CristianHuff/ConverterLoadCellToV12Lite/(commit log)

2026-06-20 Inicio do projeto de conversão dos pedais loadcell para base do PXN V12Lite
2026-06-20 Ajustes feitos para logs e calibração, projeto montado em protoboard validando o código
2026-06-21 Prototipado, validado no Gran Turismo 7 no Playstation 5, feito ajustes de calibração e testes.
2026-06-21 Adicionado led de indicação
2026-06-22 Internationalize project documentation and firmware
    - Translate README, BOM, docs, firmware comments, logs, and identifiers to English
    - Rename project files, docs, sketch folder, and schematics to English names
    - Update SVG schematic labels and layout for English text
    - Keep only the electronic schematic PNG and remove obsolete generated PNGs
    - Add calibration status LED and LED resistor to the root component list
2026-06-23 Add pedal profiles and update wiring docs
    - Add Linear/PC and GT7 inverse throttle pedal profiles
    - Apply GT7 throttle correction with an interpolated response table
    - Rework button handling for profile switching and calibration commands
    - Add LED feedback for active profile, clear, save, and hold states
    - Persist active profile only when calibration is saved to avoid EEPROM wear
    - Migrate old EEPROM calibration data on next calibration save
    - Update firmware, calibration, component, and diagnostics documentation
    - Update electronic schematic docs and SVG with the revised HX711 pin wiring
    [translator_box.ino]
2026-06-24 Add pedal profiles and stabilize bass shaker grounding
    - Add button flow for profile switching, calibration clear, and calibration save
    - Add LED feedback for profiles, hold thresholds, clear, and save actions
    - Persist the active profile only when calibration is saved to reduce EEPROM wear
    - Remap HX711 inputs and PWM outputs to match the board order: clutch, brake, throttle
    - Increase throttle dead zone to reject bass shaker vibration noise
    - Document RJ45 GND pins 2, 3, and 5 tied to common ground
    - Document bass shaker requirements: shared USB hub/reference and pedal frame bonded to translator box GND
    - Update firmware, calibration,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
    [translator_box.ino]
2026-06-28 Add PC gamepad serial bridge for Sim Ruito pedals
    Add a separate Arduino serial bridge firmware and browser-based PC bridge for using the original Sim Ruito board as the pedal reader.
    Summary:
    - Add serial_pedal_bridge Arduino sketch that receives brake/throttle/clutch percentages over USB serial and outputs PXN-compatible PWM signals.
    - Add browser Gamepad/Web Serial bridge for reading Sim Ruito pedals from the PC and sending mapped pedal values to Arduino.
    - Add Sim Ruito default axis mapping: brake axis 2, throttle axis 3, clutch axis 1.
    - Persist gamepad selection, axis mapping, calibration ranges, filters, and serial permissions where supported by the browser.
    - Add serial heartbeat, s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
2026-06-28 Build modular browser bridge with presets, calibration, diagnostics, and actionable recommendations.
    Build modular PC serial pedal bridge UI
    - Split the browser bridge into a structured tool folder with separate HTML, CSS, and JS modules
    - Add PC-side pedal profiles, GT7 inverse throttle mapping, and editable custom throttle curves
    - Add named presets, JSON import/export, guided calibration, axis capture, and per-pedal dropout guards
    - Add live telemetry, signal history, detailed logging, health alerts, and actionable recommendations
    - Keep the legacy browser bridge HTML as a compatibility launcher
    - Update PC serial bridge documentation and add a handoff summary for future work
2026-06-28 Add local COM bridge for pedal serial transport
    - Add PC-side local HTTP/PowerShell bridge for reliable Arduino COM4 serial writes
    - Add launcher scripts to start the local bridge and open the browser panel
    - Add optional Windows startup task install/uninstall scripts for the bridge
    - Add browser transport selector for Local COM bridge vs Web Serial
    - Auto-connect and auto-start the browser panel when launched through the bridge
    - Add manual pedal commands and throttle sweep tests for diagnostics
    - Add Arduino serial diagnostics, manual commands, RX packet reporting, and LED pulse feedback
    - Add standalone PWM output test sketch to isolate Arduino/PXN output wiring
    - Improve diagnostics so l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
2026-06-29 Add native Windows pedal bridge transport
    - Replace the default browser-driven pedal stream with a native PowerShell bridge
    that reads joysticks through Windows winmm and writes directly to Arduino serial
    - Add Native pedal bridge transport to the browser panel and make it the default
    - Push profile, axis mapping, calibration, deadzone, dropout guard, and TX settings
    from the panel to the local native bridge
    - Show native joystick devices in the panel to avoid browser Gamepad API limits
    - Sync native TX telemetry, pedal bars, live axes, Arduino status, and manual tests
    - Update startup scripts to launch the native bridge with auto-start enabled
    - Update startup task text, panel launcher,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
